greensensors/Irrigation-controller-on-ESP8266-and-SMT-01/RainON-on-work.pdf

### How it works

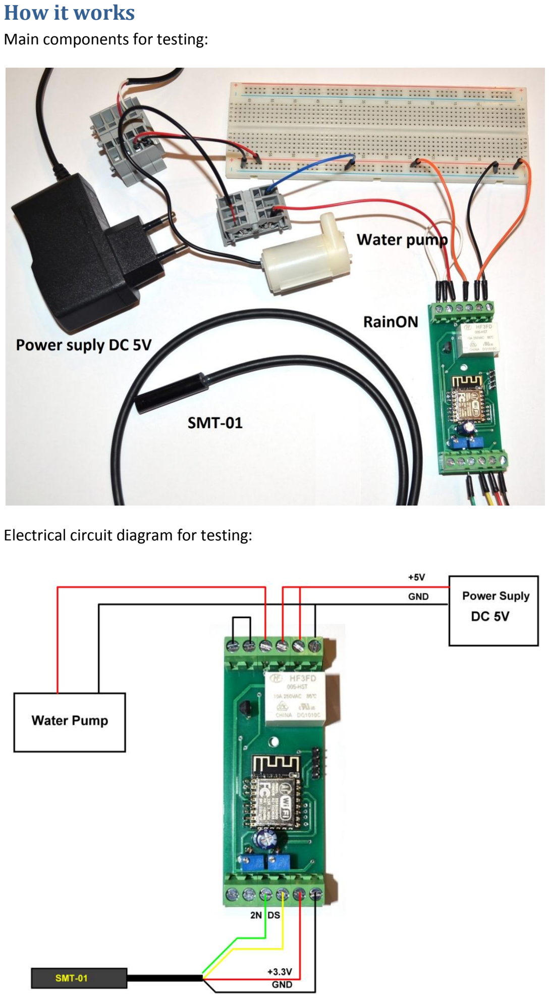
[picture p1: page 1]

Main components for testing:

Electrical circuit diagram for testing:

### Test #1: SMT-01 in water

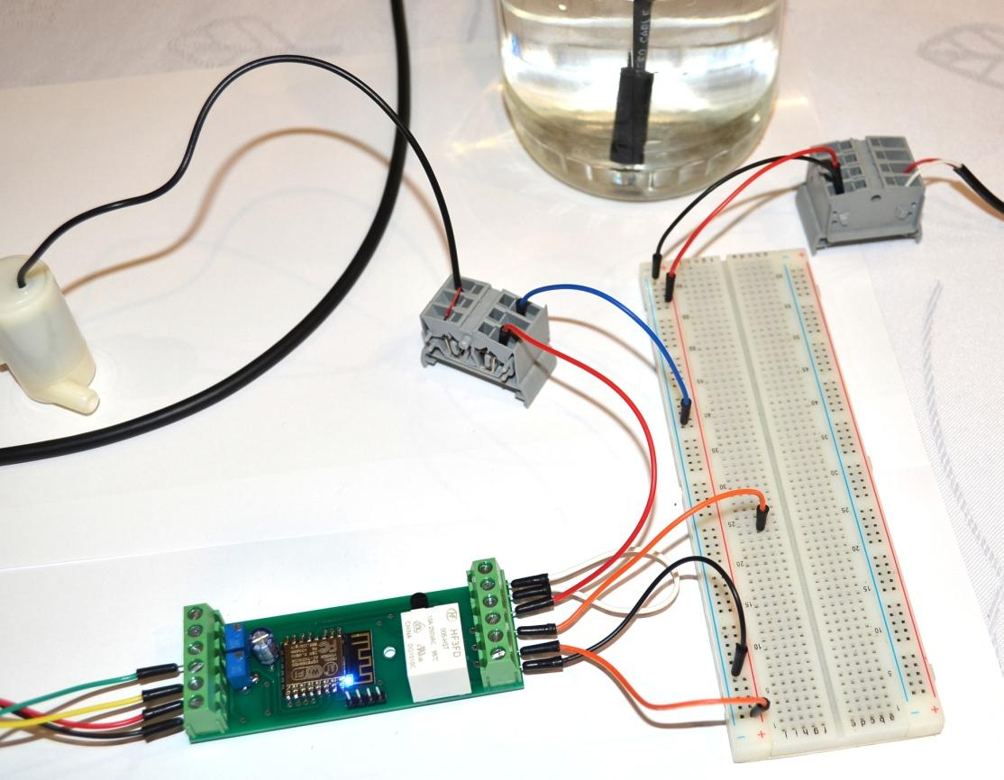
[picture p2: figure]

When the blue LED on the controller is on, the controller is measuring.

When the blue indicator of the controller is off, we connect to the WiFi access point «RainON» (password: «11111111») and see the result on WEB-page 192.168.4.1:

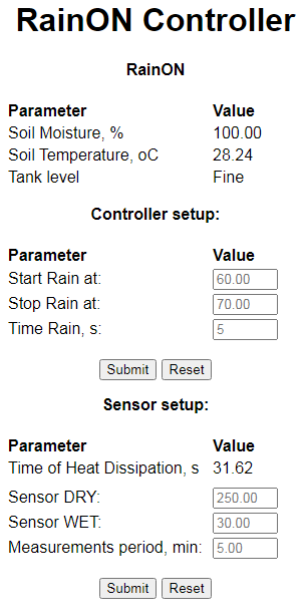
[picture p3: figure]

The Time of Heat Dissipation is 31.62 in Water. We write this value in Sensor DRY than press Submit.

Test #2: SMT-01 at open air.

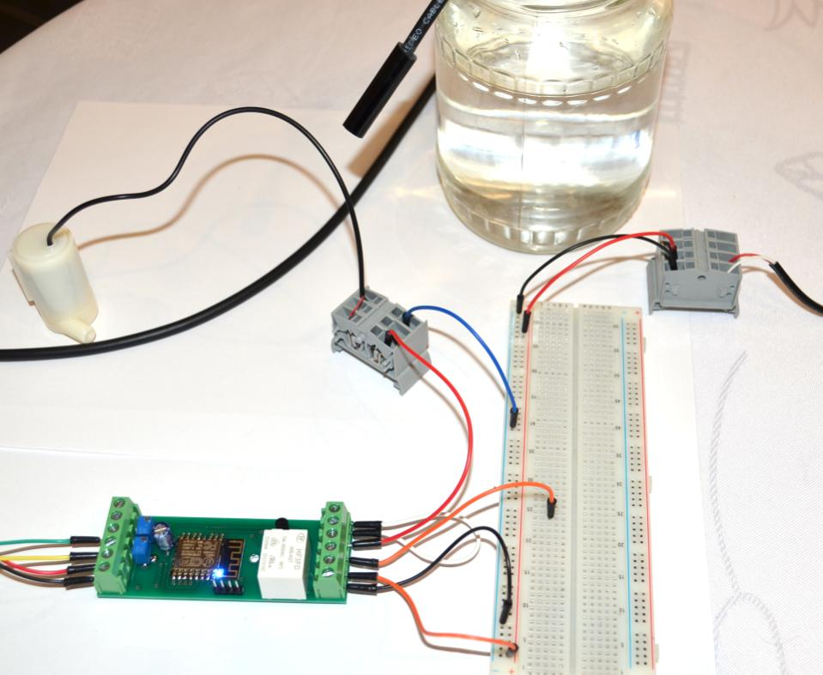
[picture p4: figure]

When the blue indicator of the controller is off, we see the result on WEB-page 192.168.4.1 (need to refresh page):

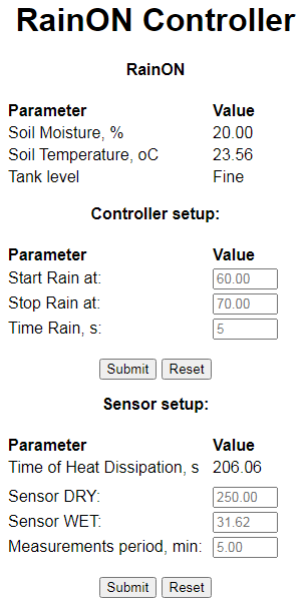
[picture p5: figure]
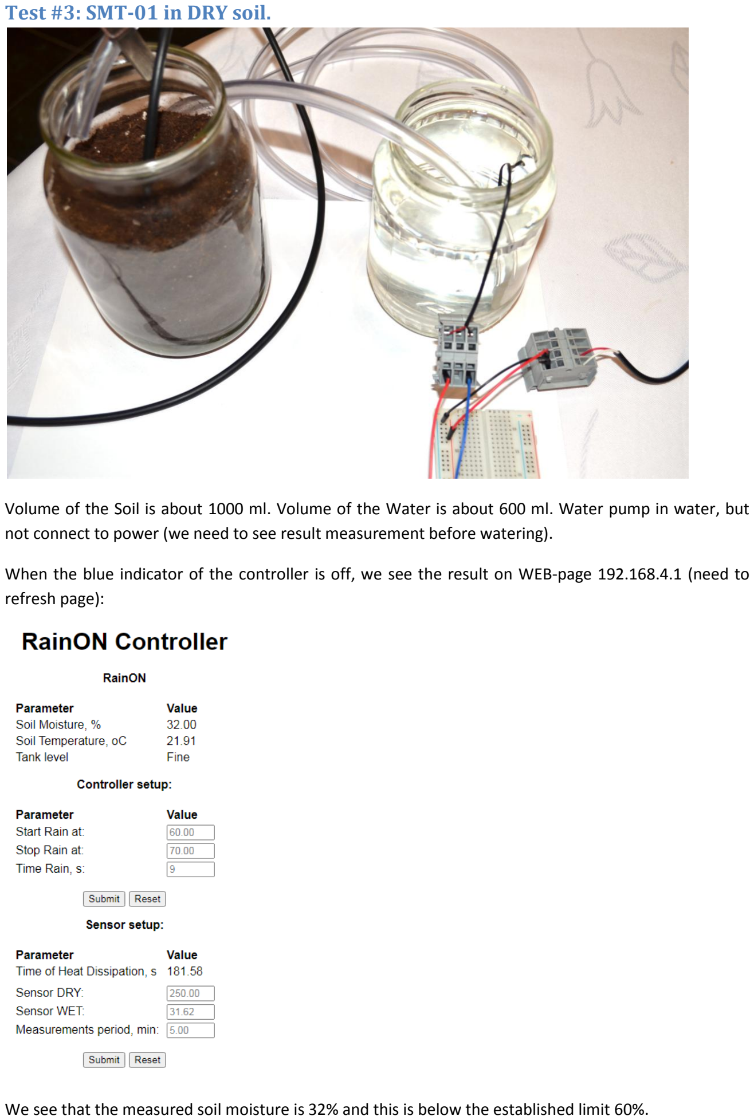
[picture p6: page 4]

Test #3: SMT-01 in DRY soil.

Volume of the Soil is about 1000 ml. Volume of the Water is about 600 ml. Water pump in water, but not connect to power (we need to see result measurement before watering).

When the blue indicator of the controller is off, we see the result on WEB-page 192.168.4.1 (need to refresh page):

We see that the measured soil moisture is 32% and this is below the established limit 60%.

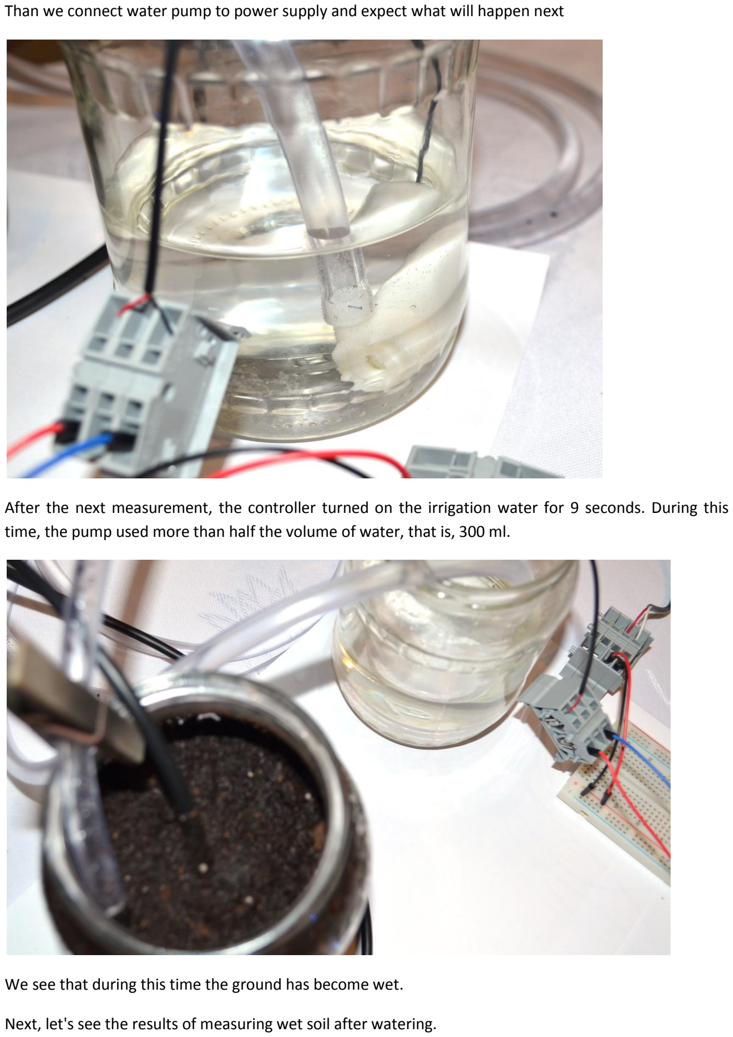
[picture p7: page 5]

Than we connect water pump to power supply and expect what will happen next

After the next measurement, the controller turned on the irrigation water for 9 seconds. During this time, the pump used more than half the volume of water, that is, 300 ml.

We see that during this time the ground has become wet.

Next, let's see the results of measuring wet soil after watering.

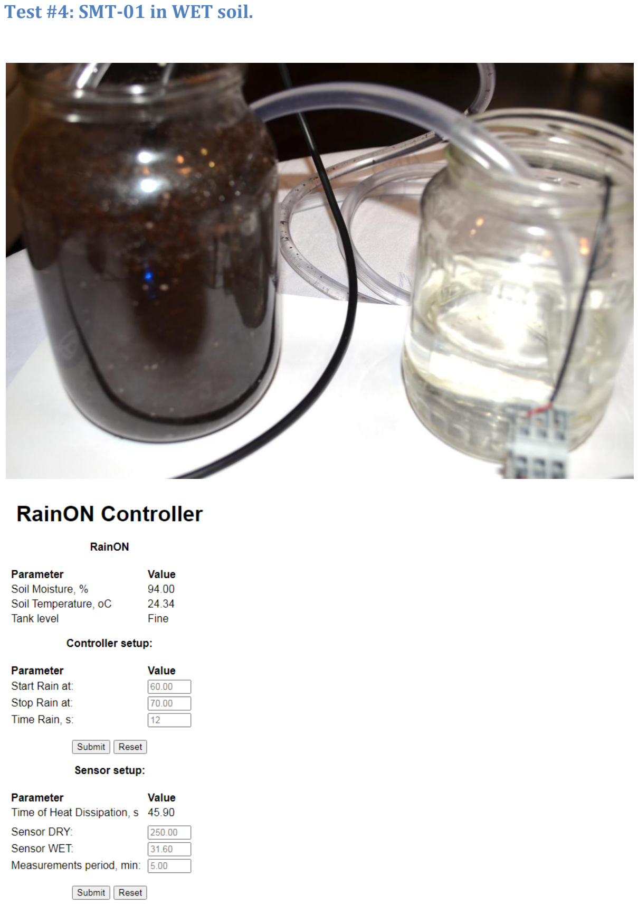
[picture p8: page 6]

Test #4: SMT-01 in WET soil.
