greensensors/Irrigation-controller-on-ESP8266-and-SMT-01/RainON-ESP8266-circuit.JPG

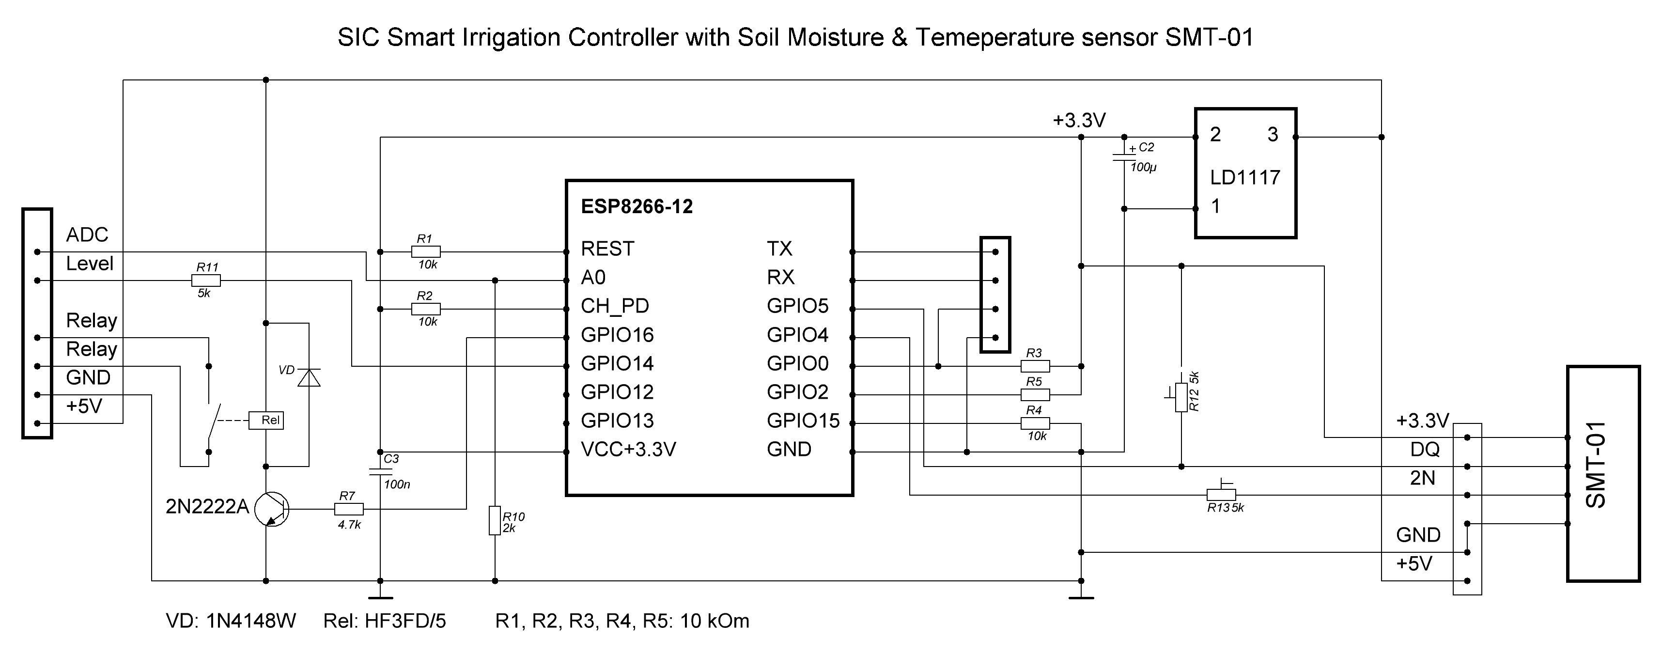
RainON-ESP8266-circuit.JPG
